jimd80/MicrobitUsbKeyboard/doc/Gamecontroller pcb.png

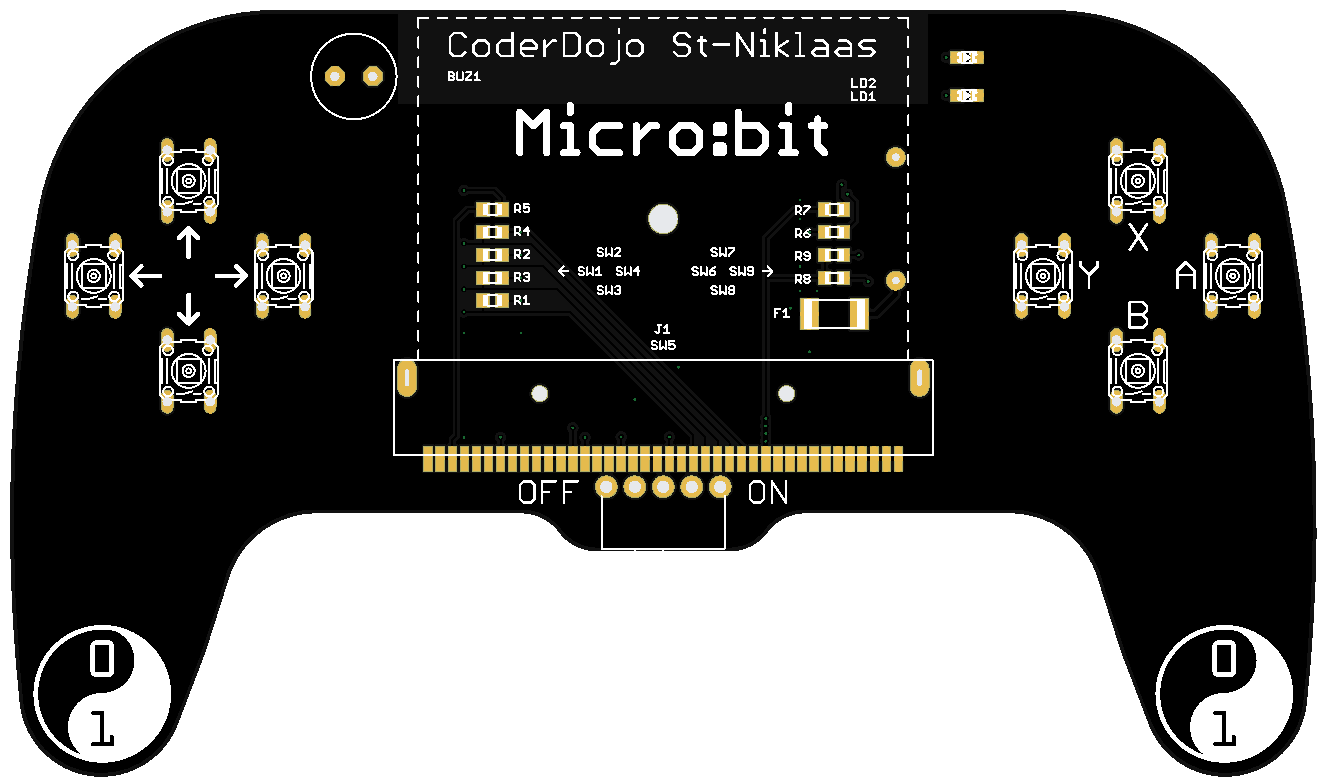
doc/Gamecontroller pcb.png
