jimd80/MicrobitUsbKeyboard/doc/Microbit case.stl

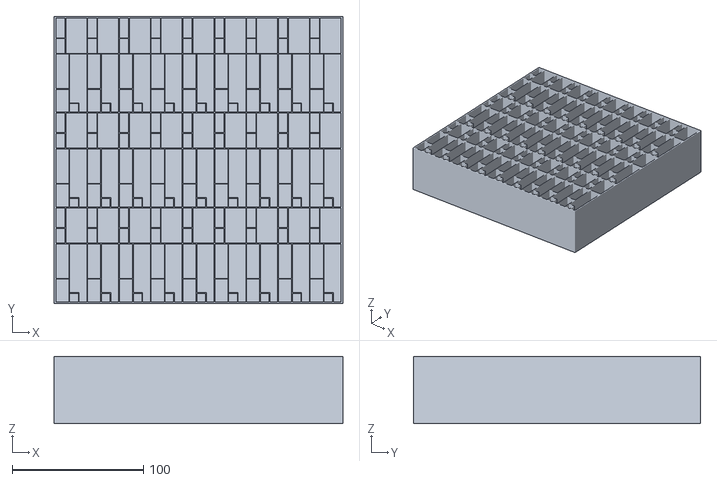
[picture p12: CAD file, 2025-01-21]
doc/Microbit case.stl
219.6 x 218.4 x 51.0
