jimd80/MicrobitUsbKeyboard/doc/Microbit case printed 1.jpg

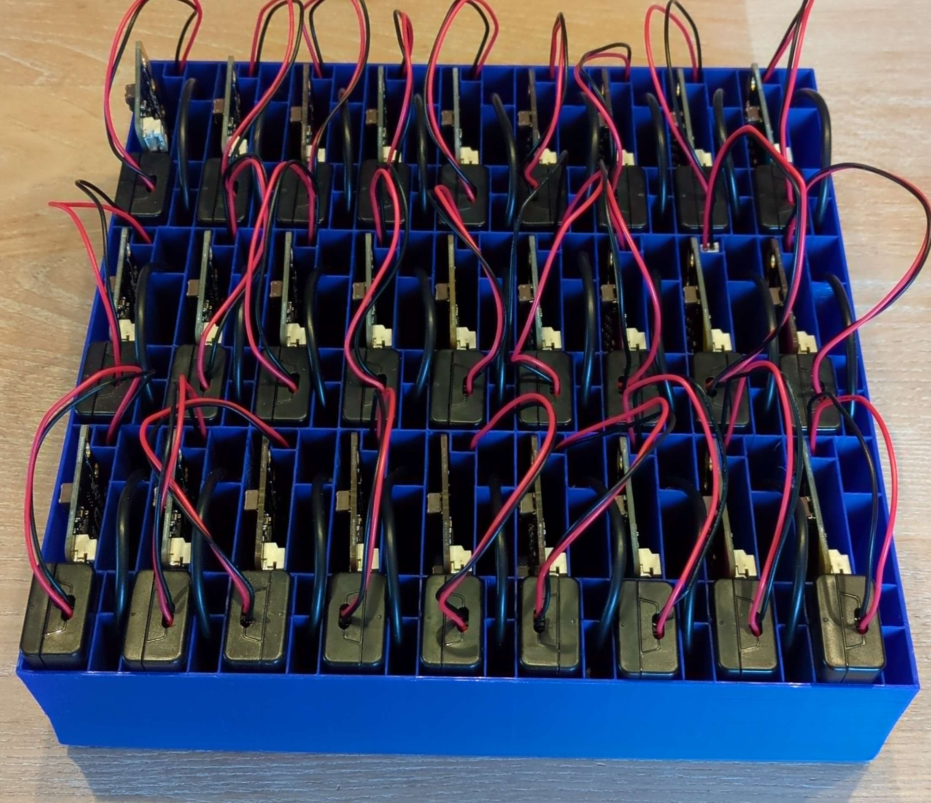
doc/Microbit case printed 1.jpg
