jimd80/MicrobitUsbKeyboard/(commit log)

2025-01-21 Initial upload
    [Microbit case.stl]
2025-03-11 Added buffer when max keydowns is reached
    [Microbit case.scad]
